mekaicb/RISC-V-SoC-Pong/(commit log)

2026-05-13 Fixed PC to include enable
    [program_counter.sv]
2026-05-14 Added a simple assembly program. Fixed byte/word addressing error in instruction memory module
    [instruction_memory.sv]
2026-05-14 Included assembly program
2026-05-16 Added basic testbench for IF/ID stages
2026-05-22 Fixes to support CPU module
    [EXMEM_buffer.sv, IDEX_buffer.sv, MEMWB_buffer.sv, control_unit.sv, reg_file.sv]
2026-05-23 Hopefully fixed logic for JALR, JAL, & LUI instructions. Added additional control signals for new MUX's in datapath.
    [control_unit.sv]
2026-05-24 Made ROM asynchronous to fix bug
    [instruction_memory.sv]
2026-05-26 Made register file writes negative edge triggered to fix bug caused by read/write on same clock cycle by instructions three stages apart, not handled natively by forwarding unit
    [reg_file.sv]
2026-06-14 Fixed error with incorrect # of address bits
    [VGA.sv, frame_buffer.sv, read_pipe.sv]
2026-06-23 Reverted negedge clock, added logic to account for 3-instruction apart read/write hazard
    [reg_file.sv]
2026-06-23 Fixed bit accessible memory to byte accessible memory
    [RAM.sv]
2026-06-23 Fixed pc stall overwriting branch instructions
    [program_counter.sv]
2026-06-23 Added flushing for all buffers to stall pipeline on a synchronous read
    [EXMEM_buffer.sv, IDEX_buffer.sv, MEMWB_buffer.sv]
